cheetah671/obstacle-avoidance/final-codes-10_adsm-main/Demos/robot2.jpeg

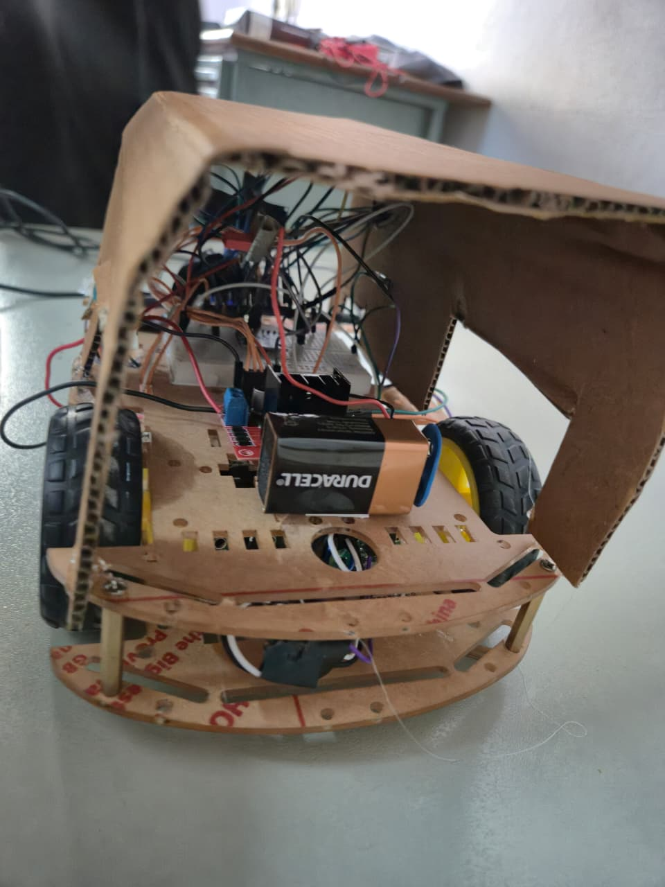
final-codes-10_adsm-main/Demos/robot2.jpeg
