cheetah671/obstacle-avoidance/final-codes-10_adsm-main/README.md

Review Assignment Due Date (https://classroom.github.com/a/Ei5Ot7FV)
# Project Title

### Team Number : 10
### Team Name : ADSM

---

NOTE : 

1. The `Demos` folder shall contain videos and Images or Readme file with link to the video(public link).
2. The `Presentation` folder shall contain **pdf** version of the presentations used for the final evalutation.
3. The `Code` folder shall contain **all**, **and any**, code used for the project.
